TokinRing/analog/README.md

# analog

This is a repo for the Simple and Inexpensive FPGA-based Fast Multichannel Acquisition Board from NISTs website.

## Resources

* https://www.nist.gov/services-resources/software/simple-and-inexpensive-fpga-based-fast-multichannel-acquisition-board
* https://www.nist.gov/services-resources/software/simple-and-inexpensive-fpga-based-fast-multichannel-acquisition-board-0
* http://www.fpga4fun.com/
