TokinRing/analog/firmware/dcfifo0_wave0.jpg

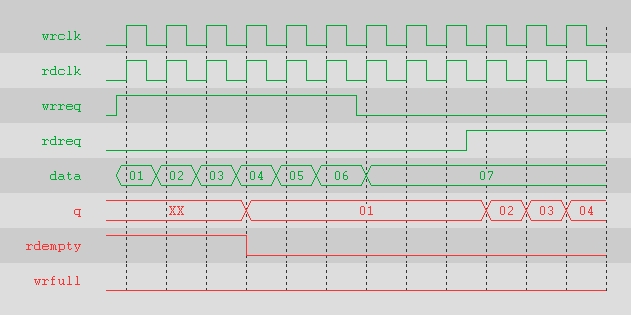
firmware/dcfifo0_wave0.jpg
