TokinRing/analog/firmware/dcfifo0_wave1.jpg

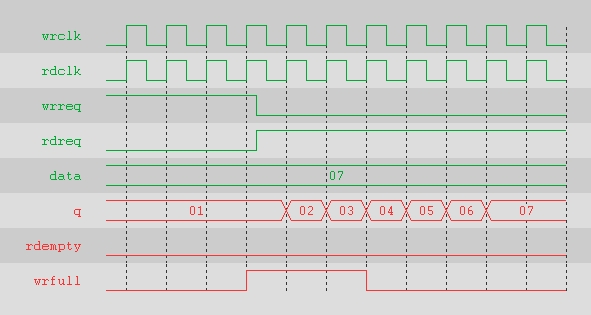
firmware/dcfifo0_wave1.jpg
