TokinRing/analog/firmware/dcfifo1_wave0.jpg

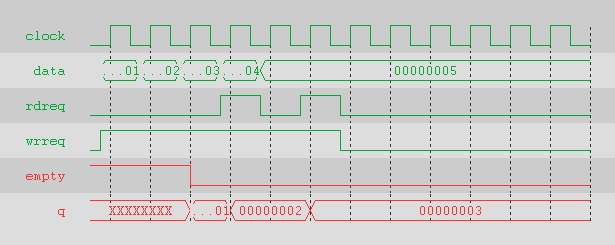
firmware/dcfifo1_wave0.jpg
