TokinRing/analog/firmware/dcfifo2_wave0.jpg

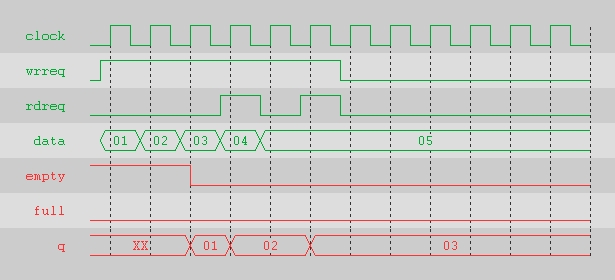
firmware/dcfifo2_wave0.jpg
