TokinRing/analog/firmware/dcfifo2_wave1.jpg

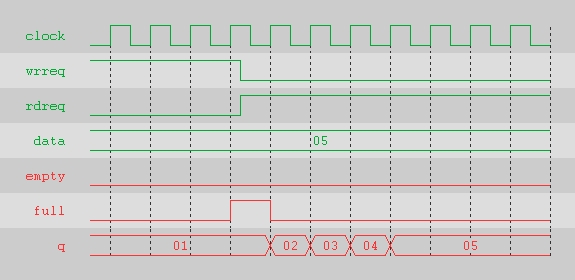
firmware/dcfifo2_wave1.jpg
