TokinRing/analog/firmware/dcfifo4_wave0.jpg

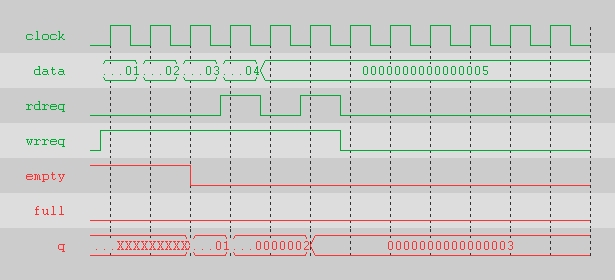
firmware/dcfifo4_wave0.jpg
