TokinRing/analog/firmware/lpm_fifo1_wave0.jpg

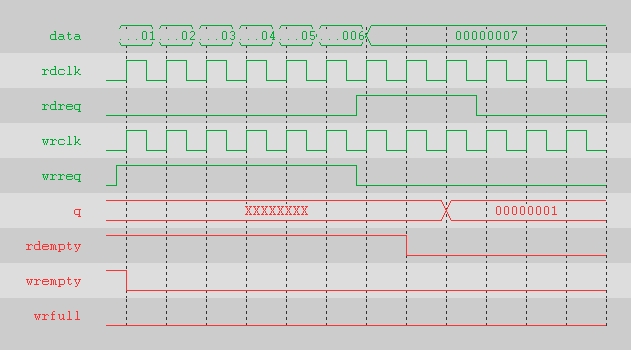
firmware/lpm_fifo1_wave0.jpg
